RobotTurtles/turtle-parts/README.md

turtle-parts
============

Physical Parts to Turtles

All CAD files are created using OpenSCAD, you can download openSCAD here: http://www.openscad.org/downloads.html

When creating new parts, please include both the scad file as well as a compiled STL for easy download.
