RobotTurtles/turtle-parts/stl_files/FirstCutAtBumps.stl

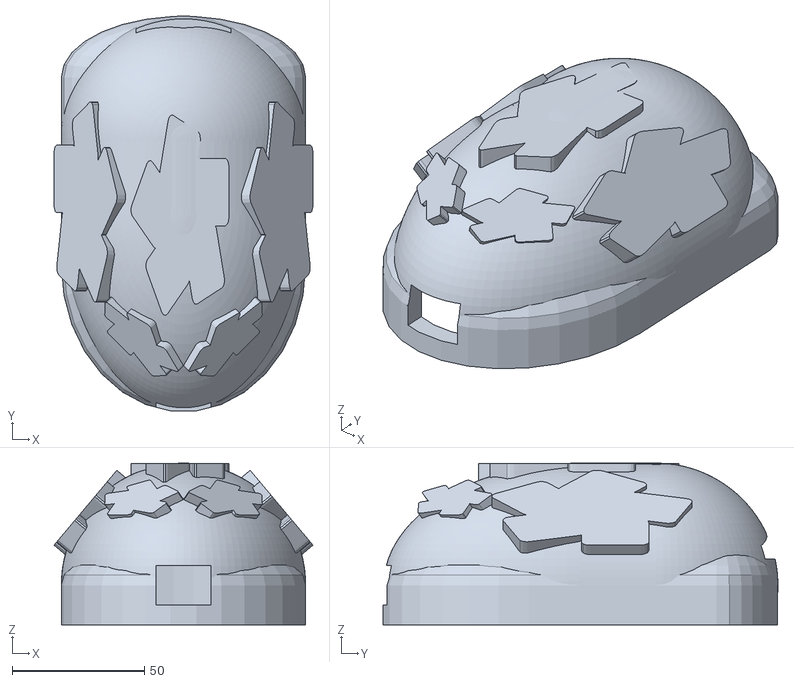
[picture p1: CAD file, 2017-07-15]
stl_files/FirstCutAtBumps.stl
98.0 x 149.5 x 61.2
