RobotTurtles/turtle-parts/stl_files/PrintableBoxCover.stl

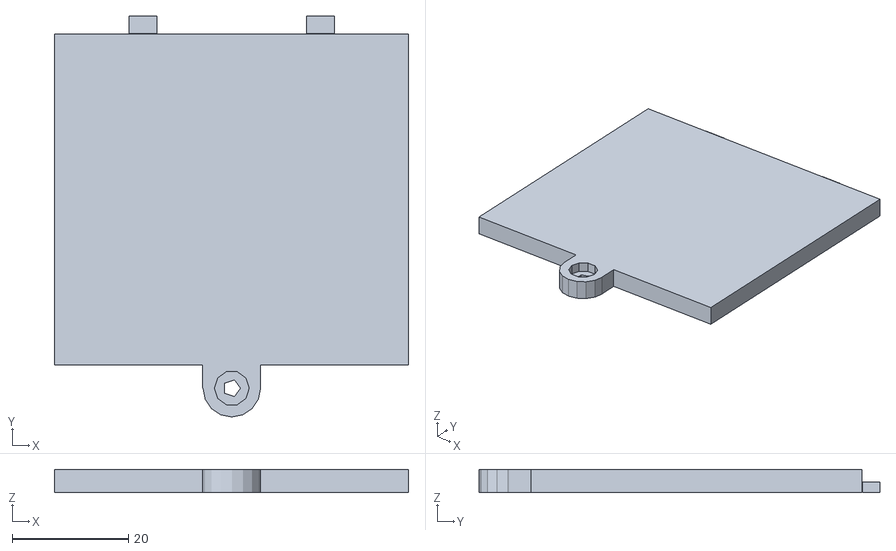
[picture p2: CAD file, 2015-12-22]
stl_files/PrintableBoxCover.stl
60.9 x 69.0 x 4.00
