RobotTurtles/turtle-parts/stl_files/RobotBase.stl

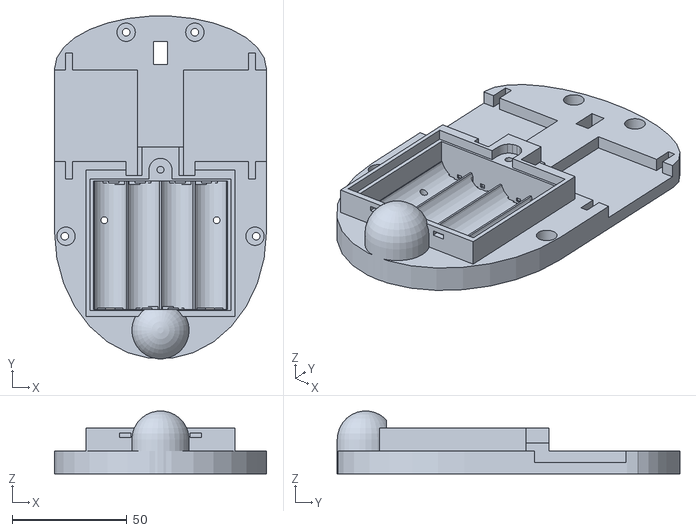
[picture p3: CAD file, 2015-12-21]
stl_files/RobotBase.stl
92.5 x 149.5 x 27.4
