RobotTurtles/turtle-parts/stl_files/RobotLeg.stl

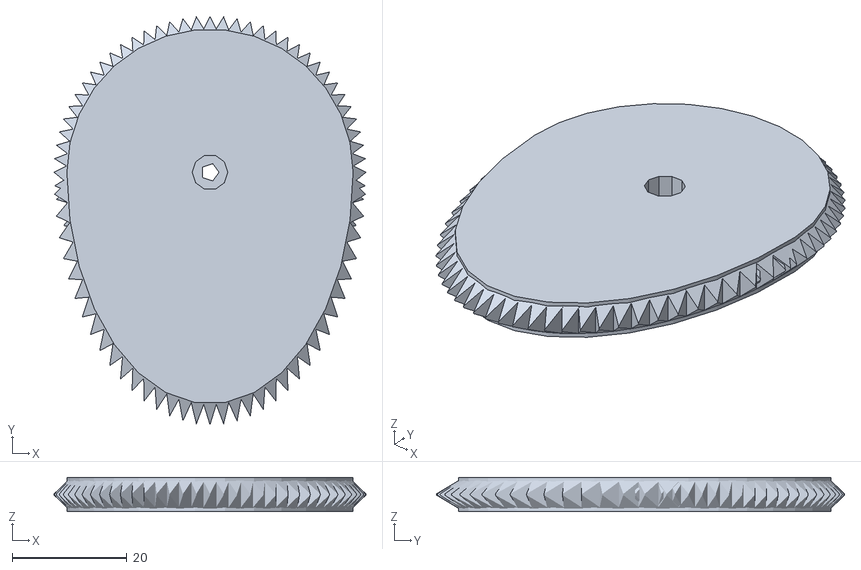
[picture p4: CAD file, 2014-12-19]
stl_files/RobotLeg.stl
54.5 x 71.3 x 6.00
