RobotTurtles/turtle-parts/stl_files/RobotShell.stl

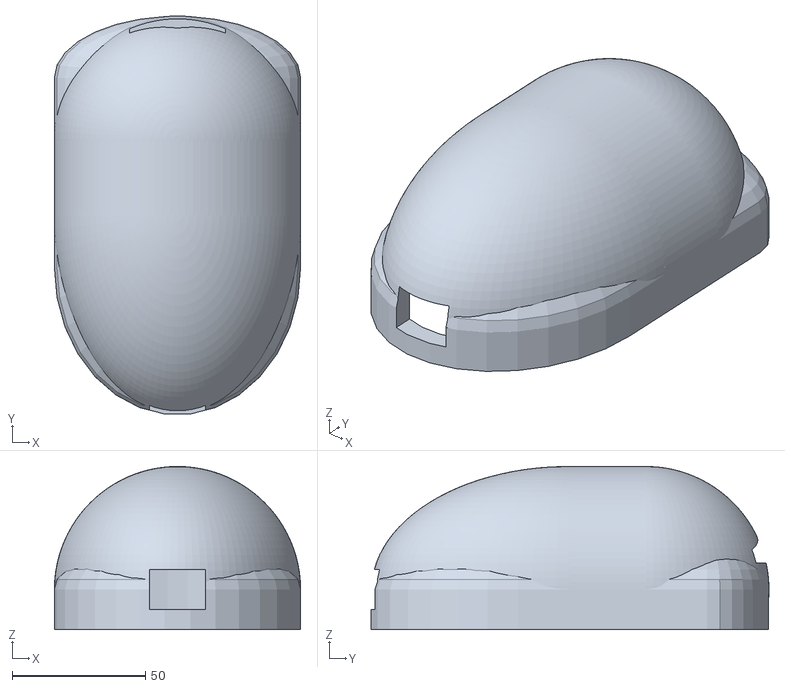
[picture p5: CAD file, 2014-12-19]
stl_files/RobotShell.stl
92.5 x 149.5 x 61.2
