RobotTurtles/turtle-parts/stl_files/BatteryBox.stl

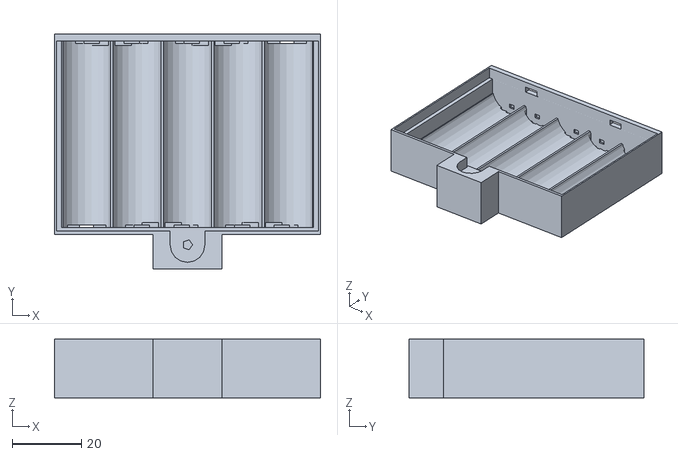
[picture p6: CAD file, 2014-12-07]
stl_files/BatteryBox.stl
77.0 x 68.0 x 17.0
