RobotTurtles/turtle-parts/stl_files/BatteryBoxCover.stl

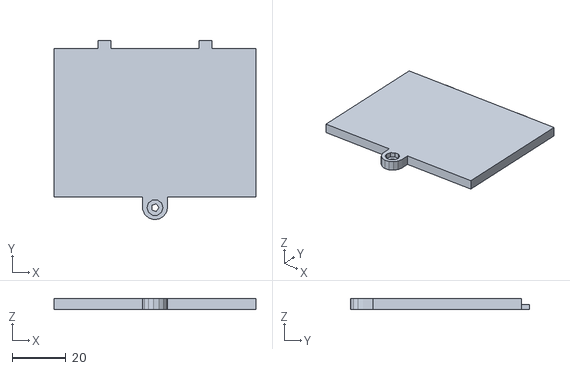
[picture p7: CAD file, 2014-12-07]
stl_files/BatteryBoxCover.stl
75.5 x 67.0 x 4.00
