RobotTurtles/turtle-parts/stl_files/ElectronicsBase.stl

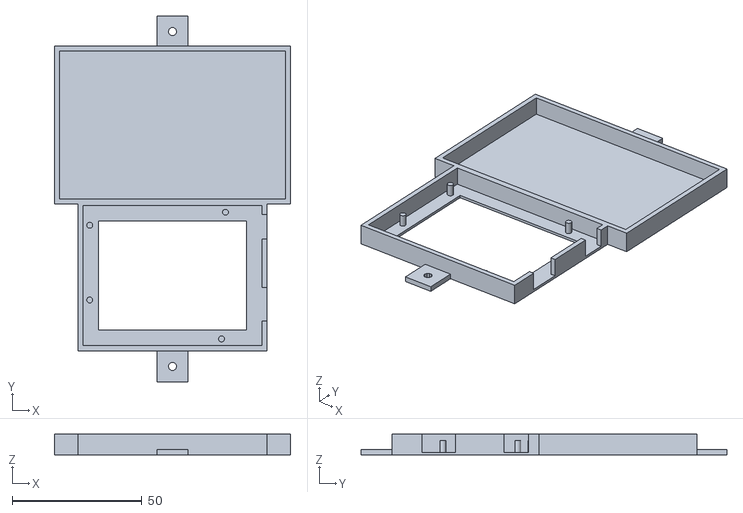
[picture p8: CAD file, 2014-11-10]
stl_files/ElectronicsBase.stl
91.0 x 141.0 x 8.00
