RobotTurtles/turtle-parts/stl_files/RobotShell_printrbot.stl

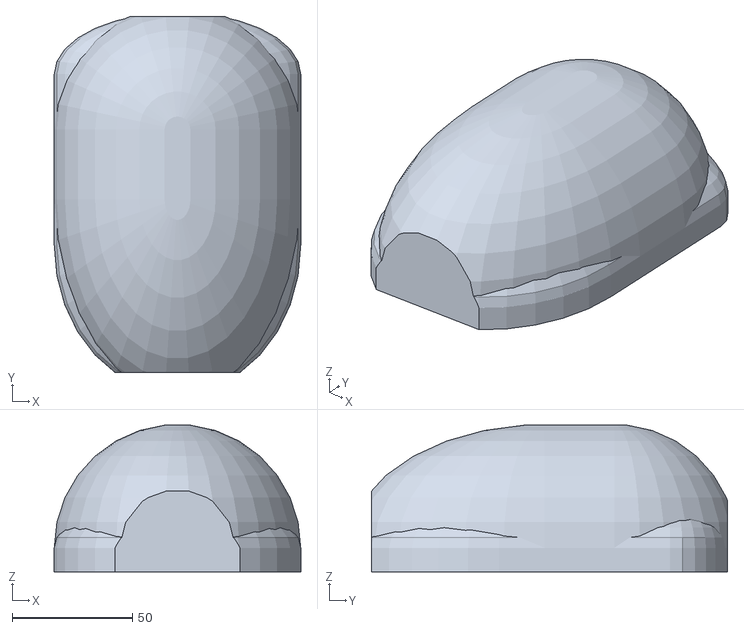
[picture p9: CAD file, 2014-11-09]
stl_files/RobotShell_printrbot.stl
102.5 x 148.0 x 61.0
