RobotTurtles/turtle-parts/RobotBase.scad

/***
 * Module: RobotBase
 * Description:
 *     Base that robot "sits" on. Mount point for servos. All Units in mm
 * Origin is at center of body lengthwise, and along the "legs"
 *
 * Author: Alex Gutierrez (firstname.lastname AT gmail)
 */

include <StandardServo.scad>;
include <BatteryBox.scad>;
include <CoreBasePlate.scad>;

module RobotBase(basewidth=92.5)
{
	GOLDEN_RATIO = 1.61803398875;
	baseThickness = 10;
	bottomPlateThickness = 5;
	motorCenterOffset = 20;

	xPosition = 30;
	tieWidth = 5;
	tieLength = 3;
	batteryHeight = 53;

	batteryBoxTranslationZ = 4.9;

	// Compute Base Length as a function of width
	baselength = basewidth * GOLDEN_RATIO;
	echo(baselength);
	
	// Upper Cylinder (by head)
	headScaleFactor = 0.5;
	headContributionToLength = (basewidth * headScaleFactor)/2;

	// Lower Cylinder (by tail)
	tailScaleFactor = 1.2;
	tailContributionToLength = (basewidth * tailScaleFactor)/2;

	centralBoxLength = baselength - headContributionToLength - tailContributionToLength;
	echo(centralBoxLength);
	batteryBoxY = 36;
	// Create Main Body
	difference(){
		union()
		{
			CoreBasePlate(basewidth, centralBoxLength, 
							  baseThickness, headScaleFactor, tailScaleFactor);

			// Add Battery Box
			translate([0,-batteryBoxY+5,batteryBoxTranslationZ])
				mirror([0,1,0])
						BatteryBox(batteryHeight=batteryHeight+5);

			// Add Caster
			translate([0, -centralBoxLength-35, 15])
				union()
				{
					sphere(d=25);
					translate([0,0,-15])
						cylinder(h=15, d=25);
				}
		}

		// Hole Pattern
		BasePlateHolePattern(basewidth, centralBoxLength, 
							  baseThickness, headScaleFactor, tailScaleFactor);

		// Hole Pattern (For Screw Head)
		BaseInsetPlateHolePattern(basewidth, centralBoxLength, 
							  baseThickness, headScaleFactor, tailScaleFactor);

		// Battery Cover
		translate([0,-batteryBoxY-1,batteryBoxTranslationZ+13.1])
				mirror([0,1,0])
					#BatteryBoxCoverCavity();

		// Left Motor
		translate([-basewidth/2 -.01,0,bottomPlateThickness])
			StandardServo();

		// Right Motor
		translate([basewidth/2 +.01,0,bottomPlateThickness])
			mirror([1,0,0])
				StandardServo();

		// Battery Cavity
		translate([0,-54-batteryBoxY-5,18])
			mirror([0,0,1])
				BatteryBoxCavity();


		// Zip Tie Holes
		union()
		{
			translate([-xPosition-tieWidth/2, 7, -5])
				cube([tieWidth,tieLength,30]);
			translate([-xPosition-tieWidth/2, -35, -5])
				cube([tieWidth,tieLength,30]);
			translate([xPosition-tieWidth/2, 7, -5])
				cube([tieWidth,tieLength,30]);
			translate([xPosition-tieWidth/2, -35, -5])
				cube([tieWidth,tieLength,30]);

		}
	}
}

RobotBase();
