RobotTurtles/turtle-parts/scad_files/enclosures/arduino_uno.scad

module ArduinoBase() 
{

arduino_width = 54;
arduino_length = 69;
arduino_usb_width = 13;
arduino_usb_height = 15;
arduino_usb_x = 9.5;
arduino_power_width = 9.5;
arduino_power_height = 15;
arduino_power_x = 3.5;

wall_thickness = 2;
wall_height = 7;
bottom_thickness = 1;
side_shoulder = 6;
drill=3.2;
ground_level = -3.55;
pin_height = 5;
pin_radius = 1.15;


difference()
{
	// Exterior box
	cube([arduino_width+(2*wall_thickness),arduino_length+(2*wall_thickness),wall_height+bottom_thickness], center=true);

	// Interior recess
	translate([0,0,bottom_thickness/2.0])
		cube([arduino_width,arduino_length,wall_height], center=true);

	// Bottom hole
	cube([arduino_width-(2*side_shoulder),arduino_length-(2*side_shoulder),wall_height+bottom_thickness], center=true);

	// USB hole
	translate([	-1*((arduino_width/2.0)-(arduino_usb_width/2.0)-arduino_usb_x),
			-1*(arduino_length/2.0)-(wall_thickness/2.0),
			-1*(wall_height/2.0 - arduino_usb_height/2.0)+bottom_thickness/2.0])
	{
		cube([arduino_usb_width,wall_thickness,arduino_usb_height], center=true);
	}

	// Power hole
	translate([	((arduino_width/2.0)-(arduino_power_width/2.0)-arduino_power_x),
			-1*(arduino_length/2.0)-(wall_thickness/2.0),
			-1*(wall_height/2.0 - arduino_power_height/2.0)+bottom_thickness/2.0])
	{
		cube([arduino_power_width,wall_thickness,arduino_power_height], center=true);
	}
	
	// Drills
	//translate ([arduino_width/2-drill/2-1,-arduino_length/2+12.5+drill/2,0]) cylinder (r=drill/2, h=10*drill, center=true, $fn=50);
	//translate ([-arduino_width/2+drill/2+1,-arduino_length/2+14+drill/2,0]) cylinder (r=drill/2, h=10*drill, center=true, $fn=50);
	//translate ([arduino_width/2-drill/2-6,+arduino_length/2-1-drill/2,0]) cylinder (r=drill/2, h=10*drill, center=true, $fn=50);
	//translate ([-arduino_width/2+drill/2+16,+arduino_length/2-1-drill/2,0]) cylinder (r=drill/2, h=10*drill, center=true, $fn=50);

}

// Raised cylinders for holding arduino
translate ([arduino_width/2-drill/2-1,-arduino_length/2+12.5+drill/2,ground_level]) cylinder (r=pin_radius, h=pin_height, $fn=50);
	translate ([-arduino_width/2+drill/2+1,-arduino_length/2+14+drill/2,ground_level]) cylinder (r=pin_radius, h=pin_height, $fn=50);
	translate ([arduino_width/2-drill/2-6,+arduino_length/2-1-drill/2,ground_level]) cylinder (r=pin_radius, h=pin_height, $fn=50);
	translate ([-arduino_width/2+drill/2+16,+arduino_length/2-1-drill/2,ground_level]) cylinder (r=pin_radius, h=pin_height, $fn=50);
}

//ArduinoBase();
