RobotTurtles/turtle-parts/scad_files/enclosures/PrintableBoxCover.scad

include <BatteryBoxCover.scad>

module PrintableBoxCover()
{
	BatteryBoxCover(tabWidth=4.9, tabThickness=2.1);
}
PrintableBoxCover();
