RobotTurtles/turtle-parts/(list of files, cad)

Other CAD files:
scad_files/bases/RobotBase.scad
scad_files/shells/RobotShell.scad
scad_files/common/CoreBasePlate.scad
scad_files/enclosures/ElectronicsBase.scad
scad_files/shells/FirstCutAtBumps.scad
