RobotTurtles/turtle-parts/electronics/ServoBoard.kicad_pcb

## KiCad design electronics/ServoBoard.kicad_pcb (2015-01-06)

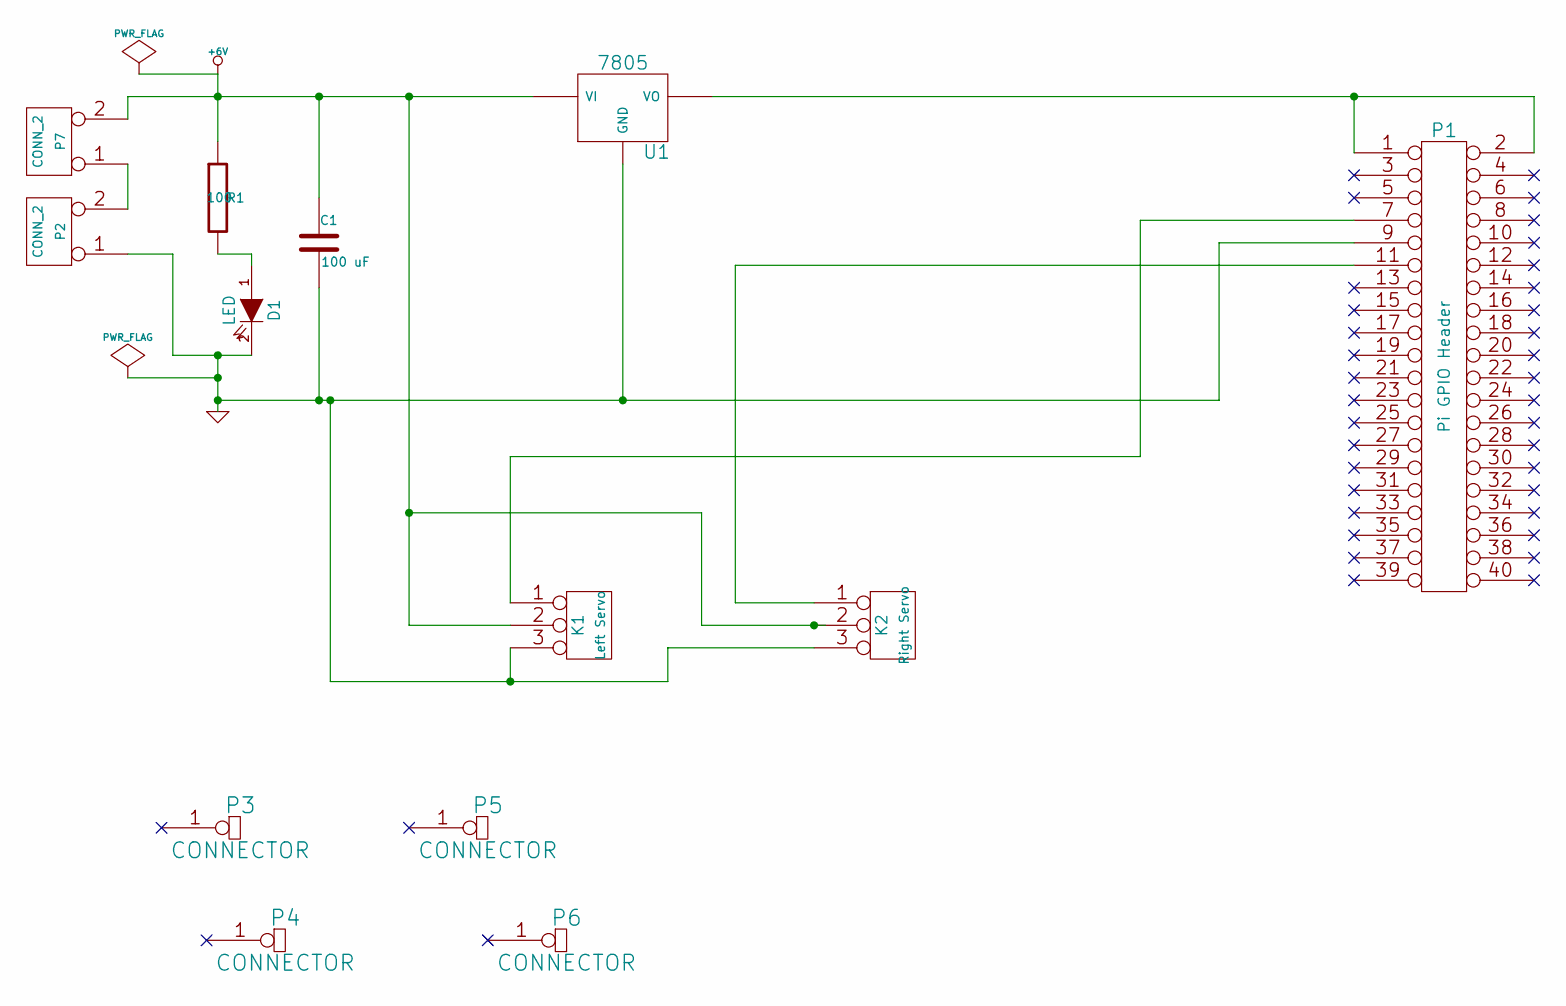
[picture p10: schematic ServoBoard.sch, Robot Turtle Servo Board]

Parts:
C1: 100 uF
D1: LED
K1: Left Servo
K2: Right Servo
P1: Pi GPIO Header
P2, P7: CONN_2
P3, P4, P5, P6: CONNECTOR
R1: 100
U1: 7805

Connections:
+6V: C1.1, K1.2 (PM), K2.2 (PM), P7.2 (PM), R1.1, U1.VI
GND: C1.2, D1.2 (K), K1.3, K2.3, P1.9, P2.1, U1.GND
unnamed: K1.1, P1.7
unnamed: K2.1, P1.11
unnamed: D1.1 (A), R1.2
unnamed: P2.2 (PM), P7.1
unnamed: P1.1, P1.2, U1.VO

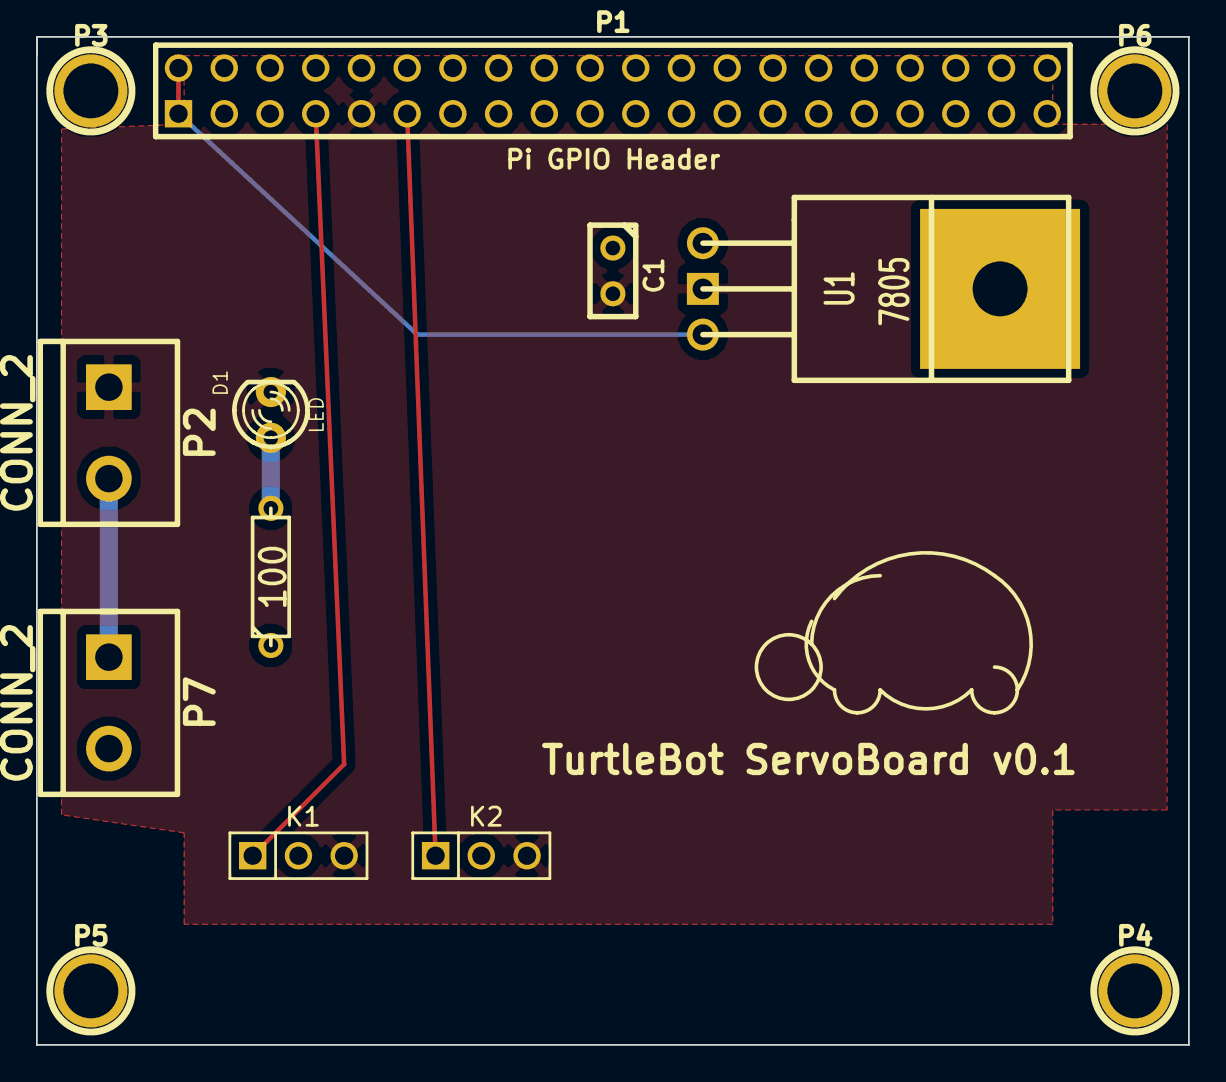
[picture p11: board ServoBoard.kicad_pcb from above]

Board: 2 copper layers, 64.0 x 56.0 mm, 13 parts (0 on the bottom side), 7 nets.
