RobotTurtles/turtle-parts/(commit log)

2014-11-01 Initial Commit of Robot Turtle Base
    [RobotBase.scad, RobotBase.stl, StandardServo.scad]
2014-11-01 Added a Battery Compartment (still rough, need to allow room for electrical wiring)
    [BatteryBox.scad, BatteryBoxCover.scad, RobotBase.scad, RobotBase.stl]
2014-11-02 Changed Battery Cover Cavity to not have dip
    [BatteryBoxCover.scad, RobotBase.scad, RobotBase.stl]
2014-11-02 Made Battery slightly taller, re-centered box
    [BatteryBox.scad, RobotBase.scad, RobotBase.stl]
2014-11-05 Updated to flip base, and add caster
    [RobotBase.scad, RobotBase.stl]
2014-11-06 Added Non Printed Parts List
2014-11-07 Added Battery Contacts to Battery Box
    [BatteryBox.scad, BatteryContacts.scad]
2014-11-07 Added STL File (forgot in last commit)
    [RobotBase.stl]
2014-11-07 Made Battery End Contacts "thicker" to allow insertion of digikey part
    [BatteryContacts.scad, RobotBase.stl]
2014-11-07 Further Updating thickness
    [BatteryContacts.scad, RobotBase.stl]
2014-11-08 Added an initial Turtle Shell
    [CoreBasePlate.scad, RobotBase.scad, RobotLeg.scad, RobotShell.scad, RobotShell.stl]
2014-11-08 Trying to work on cavity, having problems with Polyhedron
    [RobotShell.scad]
2014-11-09 Updated Robot Base to allow room for batteries. Had to modify cover and cavity to do so.
    [BatteryBox.scad, BatteryBoxCover.scad, RobotBase.scad, RobotBase.stl]
2014-11-09 Slowly trying to figure out why the cavity of the robot shell isn't working as expected.
    [RobotShell.scad]
2014-11-09 Got a cavity which compiles
    [RobotShell.scad]
2014-11-09 Successfully made cavity for robot shell. Still can be improved, but at least it compiles.
    As part of this, updated BasePlate to take a parameter.
    [CoreBasePlate.scad, RobotShell.scad, RobotShell.stl]
2014-11-09 Trying to create bounding box for printrbot
    [RobotShell_printrbot.stl, ShellForPrintrBot.scad]
2014-11-09 Working Printrbot cut
    [RobotShell.scad, RobotShell_printrbot.stl, ShellForPrintrBot.scad]
2014-11-10 Electronics! We'll probably have to adjust them slightly to fit them under the shell...
    [ElectronicsBase.scad, ElectronicsBase.stl, arduino_uno.scad, breadboard.scad, screw_attach.scad]
2014-11-11 Updated Robot Base to make battery contacts slightly tighter
    [BatteryContacts.scad, RobotBase.stl]
2014-11-11 too small, increased contact thickness
    [BatteryContacts.scad, RobotBase.stl]
2014-11-12 Robot Shell
    [RobotShell.scad, RobotShell.stl]
2014-11-12 Updated Robot Base
    [CoreBasePlate.scad, RobotBase.scad, RobotBase.stl]
2014-11-12 Added Screw Holes (first cut)
    [CoreBasePlate.scad, RobotBase.stl]
2014-11-12 Modified shell to enable Raspberry Pi to be mounted inside (worried about overhangs, but we'll see how it prints)
    [RobotShell.scad, RobotShell.stl]
2014-11-14 Trying a different way to print
    [RobotShell.scad, RobotShell.stl]
2014-11-15 Updated Shell, made hole pattern its own module
    [CoreBasePlate.scad, RobotBase.scad, RobotShell.scad, RobotShell.stl]
2014-11-15 Updated Robot Base w/ New Battery Contacts, flipped cavity so terminals are closest to tail
    [BatteryContacts.scad, RobotBase.scad, RobotBase.stl]
2014-11-17 Updated to use Raspberry Pi
2014-11-17 Updated Build of Materials
    [BuildOfMaterials.csv]
2014-11-17 Added an inset for Holes, made dual contacts thicker and more space to place. Moved up servo cable hole.
    [BatteryBox.scad, BatteryContacts.scad, CoreBasePlate.scad, RobotBase.scad, RobotBase.stl]
2014-11-21 Updated to have a "curved" up to hole. This should allow it to print cleanly
    [CoreBasePlate.scad, RobotBase.stl]
2014-11-22 Slight update to the robot leg
    [RobotLeg.scad, RobotLeg.stl]
2014-11-22 Made box cover slightly smaller than base
    [BatteryBoxCover.scad, BatteryBoxCover.stl]
2014-11-24 Updated Legs to fit servo
    [RobotLeg.scad, RobotLeg.stl]
2014-11-24 Updated Robot Legs, and Shell
    [RobotLeg.scad, RobotLeg.stl, RobotShell.scad, RobotShell.stl, WebCam.scad]
2014-11-25 Updated Shell to be rounder, and have a cleaner cavity Removed holes front/aft Allowing webcam Usb plug to get through front opening
    [RobotShell.scad, RobotShell.stl, WebCam.scad]
2014-11-26 Changed to a tent. Should print slightly better.
    [RobotShell.stl, WebCam.scad]
2014-11-28 Updated hole pattern, changing direction of insets. Made Base under shell "taller" to give room for electronics Updated Battery Contacts so it will fit better by default
    [BatteryContacts.scad, CoreBasePlate.scad, RobotBase.stl, RobotShell.scad, RobotShell.stl]
2014-12-01 Updated Build of Materials to include a wifi adapter Updated Robot Leg to no longer be circular
    [BuildOfMaterials.csv, RobotLeg.scad, RobotLeg.stl]
2014-12-03 Trying to improve center of mass to be closer to over wheels. Shifted battery box as much as I can, flipped mount direction of servos (requiring a cut out for wires)
    [RobotBase.scad, RobotBase.stl, StandardServo.scad]
2014-12-03 Moved Files around to new directories
    [BatteryBox.scad, BatteryBoxCover.scad, BatteryBoxCover.stl, CoreBasePlate.scad, ElectronicsBase.scad, ElectronicsBase.stl, RobotBase.scad, RobotBase.stl]
2014-12-06 Updated Robot Leg to have fine level of spikes
    [RobotLeg.scad, RobotLeg.stl]
2014-12-07 Repaired (seems like there is a problem?)
    [RobotLeg.stl]
2014-12-07 Updated to use sin/cos rather than calculate a circle... works much better...
    [RobotLeg.scad, RobotLeg.stl]
2014-12-07 Added more room for servo cable
    [RobotBase.scad, RobotBase.stl]
2014-12-07 Major update, added 5th battery
    [BatteryBox.scad, BatteryBox.stl, BatteryBoxCover.scad, BatteryBoxCover.stl, BatteryBoxStandAlone.scad, CoreBasePlate.scad, PrintableBoxCover.scad, RobotBase.scad]
2014-12-07 Recompiled shell with new hole pattern
    [RobotShell.stl]
2014-12-08 Made base wider, battery thicker
    [BatteryBox.scad, RobotBase.scad, RobotBase.stl]
2014-12-08 Increased width (which also makes it longer) Needed to give slightly more room for screw holes. Adjusted battery box (wasn't giving enough room for batteries) Updated Noch hole location (was incorrec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
    [BatteryBox.scad, BatteryBoxStandAlone.scad, CoreBasePlate.scad, RobotBase.scad, RobotBase.stl, RobotShell.scad, RobotShell.stl]
2014-12-09 Fixed zip tie holes
    [RobotBase.scad, RobotBase.stl]
2014-12-13 Reverted to 4 cells for batteries, thickened battery wall.
    [BatteryBox.scad, BatteryBoxCover.scad, RobotBase.scad, RobotBase.stl, RobotShell.scad]
2014-12-13 Updated with 4 AA battery size
    [RobotShell.stl]
2014-12-19 Latest version with spot for switch on shell and spikeier legs
    [RobotLeg.scad, RobotLeg.stl, RobotShell.scad, RobotShell.stl]
2015-01-02 Initial cut at a PCB for servos. Currently only a schematic
    [ServoBoard.kicad_pcb, ServoBoard.sch]
2015-01-02 Update to Battery Box Cover
    [BatteryBoxCover.scad, PrintableBoxCover.scad, PrintableBoxCover.stl]
2015-01-03 Gerber Files
    [.kicad_pcb.kicad_pcb, ServoBoard.kicad_pcb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]
2015-01-04 Updated to be 5.6 x 6.5cm in width/length.
    Moved pins to be over correct location.
    [ServoBoard.kicad_pcb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]
2015-01-05 Added 2nd connector for power, may be a bit too small
    [ServoBoard.kicad_pcb, ServoBoard.sch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]
2015-01-05 Created mount points for Raspberry Pi
    [RobotBase.scad, RobotBase.stl]
2015-01-06 Updated to use screw terminals
    [ServoBoard.kicad_pcb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]
2015-01-06 Updated Robot Base (including mount holes for Raspberry Pi)
2015-01-06 Increased mount hole diameter
    [RobotBase.stl]
2015-01-06 Updated issue with battery tabs not showing...
    [BatteryBoxCover.scad, RobotBase.scad, RobotBase.stl]
2015-02-25 Updated Parts List
    [BuildOfMaterials.csv]
2015-03-17 Updated BOM with latest pricing info,
    [BuildOfMaterials.csv]
2015-12-18 Slightly modified battery height. Updated Bill of Materials to reflect current single unit pricing
    [BatteryBox.scad, BuildOfMaterials.csv, RobotBase.stl]
2015-12-18 Updated Build of Materials to include taxes
    [BuildOfMaterials.csv]
2015-12-21 Increased Diameters for screws, and made them more round. Increased battery cover hole to be slightly larger in x Increased "width" for servo body
    [BatteryBoxCover.scad, BuildOfMaterials.csv, CoreBasePlate.scad, RobotBase.stl]
2015-12-21 Minor tweaks to get rid of "overhangs" into battery compartment
    [BatteryBoxCover.scad, PrintableBoxCover.stl, RobotBase.scad, RobotBase.stl]
2015-12-21 Cover isn't quite wide enough
    [PrintableBoxCover.scad, PrintableBoxCover.stl]
2015-12-22 Updated Build of Materials to include battery cost
    [BuildOfMaterials.csv]
2015-12-22 Updated Print Cover to have slightly shorter tabs
    [BatteryBoxCover.scad, PrintableBoxCover.stl]
2017-07-15 Added a first cut of a shell with bumps
    [FirstCutAtBumps.scad, FirstCutAtBumps.stl]
